PGRacing/BSPD-07/README.md

# BSPD-07

[Formula Student Rules 2023, Version 1.1, RULES ABOUT BSPD IN FSG](https://github.com/PGRacing/BSPD-07/blob/7362ee8c0faeef61a98c81634c0c87ed86c11af4/DOCS/Formula%20Student%20Rules%202023,%20Version%201.1,%20Rev-44c3679%20-%20FS-Rules_2023_v1.1(BSPD).pdf)
