PGRacing/BSPD-07/PCB/BSPD-07/BSPD-07.xlsx

Sheet: BSPD-07
Source:,"C:\Users\Karol\Documents\GitHub\BSPD-07\PCB\BSPD-07\BSPD-07.kicad_sch"
Date:,"17.04.2025 21:27:53"
Tool:,"Eeschema (6.0.8)"
Generator:,"C:\Program Files\KiCad\6.0\bin\scripting\plugins/bom_csv_grouped_by_value.py"
Component Count:,"82"
Individual Components:
Item,"Qty","Reference(s)","Value","LibPart","Footprint","Datasheet","Arrow Part Number","Arrow Price/Stock","Description","Height","Manufacturer_Name","Manufacturer_Part_Number","Mouser Part Number","Mouser Price/Stock"
,"","C1","0.1uF","Device:C_Small","Capacitor_SMD:C_0402_1005Metric","~","","","","","","","",""
,"","C2","0.1uF","Device:C_Small","Capacitor_SMD:C_0402_1005Metric","~","","","","","","","",""
,"","C3","10uF","Device:C_Small","Capacitor_SMD:C_0805_2012Metric","~","","","","","","","",""
,"","C4","0.1uF","Device:C_Small","Capacitor_SMD:C_0402_1005Metric","~","","","","","","","",""
,"","C5","10uF","Device:C_Small","Capacitor_SMD:C_1206_3216Metric","~","","","","","","","",""
,"","C6","1uF","Device:C_Small","Capacitor_SMD:C_0805_2012Metric","~","","","","","","","",""
,"","C7","4.7uF","Device:C_Small","Capacitor_SMD:C_0805_2012Metric","~","","","","","","","",""
,"","C8","0.1u","Device:C_Small","Capacitor_SMD:C_0402_1005Metric","~","","","","","","","",""
,"","C9","0.1uF","Device:C_Small","Capacitor_SMD:C_0402_1005Metric","~","","","","","","","",""
,"","C10","na","Device:C_Small","Capacitor_SMD:C_0402_1005Metric","~","","","","","","","",""
,"","C11","na","Device:C_Small","Capacitor_SMD:C_0402_1005Metric","~","","","","","","","",""
,"","C12","10uF","Device:C_Small","Capacitor_SMD:C_1206_3216Metric","~","","","","","","","",""
,"","C13","10uF","Device:C_Small","Capacitor_SMD:C_1206_3216Metric","~","","","","","","","",""
,"","C14","10uF","Device:C_Small","Capacitor_SMD:C_1206_3216Metric","~","","","","","","","",""
,"","C15","10uF","Device:C_Small","Capacitor_SMD:C_1206_3216Metric","~","","","","","","","",""
,"","C16","10uF","Device:C_Small","Capacitor_SMD:C_1206_3216Metric","~","","","","","","","",""
,"","C17","10uF","Device:C_Small","Capacitor_SMD:C_1206_3216Metric","~","","","","","","","",""
,"","C18","10uF","Device:C_Small","Capacitor_SMD:C_1206_3216Metric","~","","","","","","","",""
,"","C19","10uF","Device:C_Small","Capacitor_SMD:C_1206_3216Metric","~","","","","","","","",""
,"","C20","10uF","Device:C_Small","Capacitor_SMD:C_1206_3216Metric","~","","","","","","","",""
,"","C21","100pF/50V","Device:C_Small","Capacitor_SMD:C_0402_1005Metric","~","","","","","","","",""
,"","C22","100nF/50V","Device:C_Small","Capacitor_SMD:C_0402_1005Metric","~","","","","","","","",""
,"","D1","7V","Device:D_TVS","Diode_SMD:D_0402_1005Metric","~","","","","","","","",""
,"","D2","7V","Device:D_TVS","Diode_SMD:D_0402_1005Metric","~","","","","","","","",""
,"","D3","LED","Device:LED","Diode_SMD:D_0402_1005Metric_Pad0.77x0.64mm_HandSolder","~","","","","","","","",""
,"","D4","LED","Device:LED","Diode_SMD:D_0402_1005Metric_Pad0.77x0.64mm_HandSolder","~","","","","","","","",""
,"","D5","28V","Device:D_TVS","Diode_SMD:D_SMA","~","","","","","","","",""
,"","D6","1N4448WS","Diode:1N4448WS","Diode_SMD:D_SOD-323","https://www.vishay.com/docs/81387/1n4448ws.pdf","","","","","","","",""
,"","F1","500mA","Device:Fuse_Small","Fuse:Fuse_0805_2012Metric","~","","","","","","","",""
,"","FB1","110E","Device:FerriteBead_Small","LED_SMD:LED_0805_2012Metric","~","","","","","","","",""
,"","IC1","LM393LVQDRQ1","BSPD-07:LM393LVQDRQ1","BSPD_07:SOIC127P600X175-8N","https://www.ti.com/lit/gpn/lm393lv-q1","LM393LVQDRQ1","https://www.arrow.com/en/products/lm393lvqdrq1/texas-instruments?region=nac","Analog Comparators Automotive low-voltage commodity comparator 8-SOIC -40 to 125","1.75","Texas Instruments","LM393LVQDRQ1","595-LM393LVQDRQ1","https://www.mouser.co.uk/ProductDetail/Texas-Instruments/LM393LVQDRQ1?qs=IS%252B4QmGtzzqk8QFsvXuXMw%3D%3D"
,"","IC2","LM393LVQDRQ1","BSPD-07:LM393LVQDRQ1","BSPD_07:SOIC127P600X175-8N","https://www.ti.com/lit/gpn/lm393lv-q1","LM393LVQDRQ1","https://www.arrow.com/en/products/lm393lvqdrq1/texas-instruments?region=nac","Analog Comparators Automotive low-voltage commodity comparator 8-SOIC -40 to 125","1.75","Texas Instruments","LM393LVQDRQ1","595-LM393LVQDRQ1","https://www.mouser.co.uk/ProductDetail/Texas-Instruments/LM393LVQDRQ1?qs=IS%252B4QmGtzzqk8QFsvXuXMw%3D%3D"
,"","IC3","LM393LVQDRQ1",":LM393LVQDRQ1_1","BSPD_07:SOIC127P600X175-8N","https://www.ti.com/lit/gpn/lm393lv-q1","LM393LVQDRQ1","https://www.arrow.com/en/products/lm393lvqdrq1/texas-instruments?region=nac","Analog Comparators Automotive low-voltage commodity comparator 8-SOIC -40 to 125","1.75","Texas Instruments","LM393LVQDRQ1","595-LM393LVQDRQ1","https://www.mouser.co.uk/ProductDetail/Texas-Instruments/LM393LVQDRQ1?qs=IS%252B4QmGtzzqk8QFsvXuXMw%3D%3D"
,"","IC4","LDO40LPU50RY","BSPD-07:LDO40LPU50RY","BSPD_07:SON95P300X300X90-7N-D","https://componentsearchengine.com/Datasheets/1/LDO40LPU50RY.pdf","LDO40LPU50RY","https://www.arrow.com/en/products/ldo40lpu50ry/stmicroelectronics?region=nac","LDO Voltage Regulators 400 mA, 38 V low-dropout regulator","0.9","STMicroelectronics","LDO40LPU50RY","511-LDO40LPU50RY","https://www.mouser.co.uk/ProductDetail/STMicroelectronics/LDO40LPU50RY?qs=qSfuJ%252Bfl%2Fd76TFu8P3XttQ%3D%3D"
,"","IC5","74LVC1G02GW-Q100H","BSPD-07:74LVC1G02GW-Q100H","BSPD_07:SOT65P212X110-5N","https://assets.nexperia.com/documents/data-sheet/74LVC1G02_Q100.pdf","74LVC1G02GW-Q100H","https://www.arrow.com/en/products/74lvc1g02gw-q100h/nexperia","Single 2-input NOR gate@en-us","1.1","Nexperia","74LVC1G02GW-Q100H","771-74LVC1G02GWQ100H","https://www.mouser.co.uk/ProductDetail/Nexperia/74LVC1G02GW-Q100H?qs=5XOdhvmYM0OXtjyYuTuWfw%3D%3D"
,"","IC6","LM393LVQDRQ1","BSPD-07:LM393LVQDRQ1","BSPD_07:SOIC127P600X175-8N","https://www.ti.com/lit/gpn/lm393lv-q1","LM393LVQDRQ1","https://www.arrow.com/en/products/lm393lvqdrq1/texas-instruments?region=nac","Analog Comparators Automotive low-voltage commodity comparator 8-SOIC -40 to 125","1.75","Texas Instruments","LM393LVQDRQ1","595-LM393LVQDRQ1","https://www.mouser.co.uk/ProductDetail/Texas-Instruments/LM393LVQDRQ1?qs=IS%252B4QmGtzzqk8QFsvXuXMw%3D%3D"
,"","J1","DTM13-12PA","BSPD-07:DTM13-12PA","BSPD_07:DTM1312PA","https://datasheet.datasheetarchive.com/originals/distributors/DKDS-22/431684.pdf","","","Automotive Connectors 12P SZ 20 DTM RECP","35.18","TE Connectivity","DTM13-12PA","571-DTM13-12PA","https://www.mouser.co.uk/ProductDetail/TE-Connectivity-DEUTSCH/DTM13-12PA?qs=cgQJD%2FpJz0wRVbmAAJ6nZw%3D%3D"
,"","JP1","Jumper_2_Open","Jumper:Jumper_2_Open","Connector_PinHeader_2.54mm:PinHeader_1x02_P2.54mm_Vertical","~","","","","","","","",""
,"","L1","120uH / 0.5A","Device:L_Small","Inductor_SMD:L_1812_4532Metric","~","","","","","","","",""
,"","Q1","RSQ025P03HZGTR","BSPD-07:RSQ025P03HZGTR","BSPD_07:SOT95P280X100-6N","https://fscdn.rohm.com/en/products/databook/datasheet/discrete/transistor/mosfet/rsq025p03hzgtr-e.pdf","","","Pch -30V -2.5A Small Signal MOSFET","1","ROHM Semiconductor","RSQ025P03HZGTR","755-RSQ025P03HZGTR","https://www.mouser.co.uk/ProductDetail/ROHM-Semiconductor/RSQ025P03HZGTR?qs=0lSvoLzn4L%2F9YbrdTwpoKg%3D%3D"
,"","Q2","RJU002N06FRAT106","BSPD-07:RJU002N06FRAT106","BSPD_07:SOT65P210X100-3N","https://datasheet.datasheetarchive.com/originals/distributors/DKDS-10/185695.pdf","","","ROHM - RJU002N06FRAT106 - MOSFET, AEC-Q101, N-CH, 60V, 0.2A, UMT3","1","ROHM Semiconductor","RJU002N06FRAT106","755-RJU002N06FRAT106","https://www.mouser.com/Search/Refine.aspx?Keyword=755-RJU002N06FRAT106"
,"","Q3","RJU002N06FRAT106","BSPD-07:RJU002N06FRAT106","BSPD_07:SOT65P210X100-3N","https://datasheet.datasheetarchive.com/originals/distributors/DKDS-10/185695.pdf","","","ROHM - RJU002N06FRAT106 - MOSFET, AEC-Q101, N-CH, 60V, 0.2A, UMT3","1","ROHM Semiconductor","RJU002N06FRAT106","755-RJU002N06FRAT106","https://www.mouser.com/Search/Refine.aspx?Keyword=755-RJU002N06FRAT106"
,"","Q4","AO3401A","Transistor_FET:AO3401A","Package_TO_SOT_SMD:SOT-23","http://www.aosmd.com/pdfs/datasheet/AO3401A.pdf","","","","","","","",""
,"","R1","100k","Device:R_Small","Resistor_SMD:R_0402_1005Metric","~","","","","","","","",""
,"","R2","100k","Device:R_Small","Resistor_SMD:R_0402_1005Metric","~","","","","","","","",""
,"","R3","5k-10k","Device:R_Small","Resistor_SMD:R_0402_1005Metric","~","","","","","","","",""
,"","R4","10k","Device:R_Small","Resistor_SMD:R_0402_1005Metric","~","","","","","","","",""
,"","R5","5k-10k","Device:R_Small","Resistor_SMD:R_0402_1005Metric","~","","","","","","","",""
,"","R6","10k","Device:R_Small","Resistor_SMD:R_0402_1005Metric","~","","","","","","","",""
,"","R7","200k","Device:R_Small","Resistor_SMD:R_0402_1005Metric","~","","","","","","","",""
,"","R8","200k","Device:R_Small","Resistor_SMD:R_0402_1005Metric","~","","","","","","","",""
,"","R9","10k","Device:R_Small","Resistor_SMD:R_0402_1005Metric","~","","","","","","","",""
,"","R10","10k","Device:R_Small","Resistor_SMD:R_0402_1005Metric","~","","","","","","","",""
,"","R11","100k","Device:R_Small","Resistor_SMD:R_0402_1005Metric","~","","","","","","","",""
,"","R12","39k","Device:R_Small","Resistor_SMD:R_0402_1005Metric","~","","","","","","","",""
,"","R13","39k","Device:R_Small","Resistor_SMD:R_0402_1005Metric","~","","","","","","","",""
,"","R14","5R2","Device:R_Small","Resistor_SMD:R_0402_1005Metric","~","","","","","","","",""
,"","R15","560k","Device:R_Small","Resistor_SMD:R_0402_1005Metric","~","","","","","","","",""
,"","R16","100","Device:R_Small","Resistor_SMD:R_0402_1005Metric","~","","","","","","","",""
,"","R17","10k","Device:R_Small","Resistor_SMD:R_0402_1005Metric","~","","","","","","","",""
,"","R18","10k","Device:R_Small","Resistor_SMD:R_0402_1005Metric","~","","","","","","","",""
,"","R19","10k","Device:R_Small","Resistor_SMD:R_0402_1005Metric","~","","","","","","","",""
,"","R20","560k","Device:R_Small","Resistor_SMD:R_0402_1005Metric","~","","","","","","","",""
,"","R21","3R9","Device:R_Small","Resistor_SMD:R_0402_1005Metric","~","","","","","","","",""
,"","R22","1k","Device:R_Small","Resistor_SMD:R_0402_1005Metric","~","","","","","","","",""
,"","R23","152","Device:R_Small","Resistor_SMD:R_0402_1005Metric","~","","","","","","","",""
,"","R24","145","Device:R_Small","Resistor_SMD:R_0402_1005Metric","~","","","","","","","",""
,"","R25","39k","Device:R_Small","Resistor_SMD:R_0402_1005Metric","~","","","","","","","",""
,"","R26","10k","Device:R_Small","Resistor_SMD:R_0402_1005Metric","~","","","","","","","",""
,"","R27","200R","Device:R_Small","Resistor_SMD:R_0402_1005Metric","~","","","","","","","",""
,"","R28","100","Device:R_Small","Resistor_SMD:R_0402_1005Metric","~","","","","","","","",""
,"","R29","200","Device:R_Small","Resistor_SMD:R_0402_1005Metric","~","","","","","","","",""
,"","R30","10k","Device:R_Small","Resistor_SMD:R_0402_1005Metric","~","","","","","","","",""
,"","R31","na","Device:R_Small","Resistor_SMD:R_0402_1005Metric","~","","","","","","","",""
,"","R32","na","Device:R_Small","Resistor_SMD:R_0402_1005Metric","~","","","","","","","",""
,"","RV1","20k","Device:R_Potentiometer_Small","BSPD_07:POT-3296X1223LF","~","","","","","","","",""
,"","RV2","20k","Device:R_Potentiometer_Small","BSPD_07:POT-3296X1223LF","~","","","","","","","",""
,"","TP1","TPS","Connector:TestPoint_Small","TestPoint:TestPoint_Pad_D1.0mm","~","","","","","","","",""
,"","TP2","BRK","Connector:TestPoint_Small","TestPoint:TestPoint_Pad_D1.0mm","~","","","","","","","",""
,"","TP3","ERR_FINAL","Connector:TestPoint_Small","TestPoint:TestPoint_Pad_D1.0mm","~","","","","","","","",""
,"","TP4","CUR","Connector:TestPoint_Small","TestPoint:TestPoint_Pad_D1.0mm","~","","","","","","","",""
,"","U2","TLP175A / COMUS AB38-Q","Relay_SolidState:TLP175A","Package_SO:MFSOP6-4_4.4x3.6mm_P1.27mm","https://toshiba.semicon-storage.com/info/docget.jsp?did=13665&prodName=TLP175A","","","","","","","",""
Collated Components:
Item,"Qty","Reference(s)","Value","LibPart","Footprint","Datasheet","Arrow Part Number","Arrow Price/Stock","Description","Height","Manufacturer_Name","Manufacturer_Part_Number","Mouser Part Number","Mouser Price/Stock"
1,"4","C1, C2, C4, C9","0.1uF","Device:C_Small","Capacitor_SMD:C_0402_1005Metric","~","","","","","","","",""
2,"1","C3","10uF","Device:C_Small","Capacitor_SMD:C_0805_2012Metric","~","","","","","","","",""
3,"10","C5, C12, C13, C14, C15, C16, C17, C18, C19, C20","10uF","Device:C_Small","Capacitor_SMD:C_1206_3216Metric","~","","","","","","","",""
4,"1","C6","1uF","Device:C_Small","Capacitor_SMD:C_0805_2012Metric","~","","","","","","","",""
5,"1","C7","4.7uF","Device:C_Small","Capacitor_SMD:C_0805_2012Metric","~","","","","","","","",""
6,"1","C8","0.1u","Device:C_Small","Capacitor_SMD:C_0402_1005Metric","~","","","","","","","",""
7,"2","C10, C11","na","Device:C_Small","Capacitor_SMD:C_0402_1005Metric","~","","","","","","","",""
8,"1","C21","100pF/50V","Device:C_Small","Capacitor_SMD:C_0402_1005Metric","~","","","","","","","",""
9,"1","C22","100nF/50V","Device:C_Small","Capacitor_SMD:C_0402_1005Metric","~","","","","","","","",""
10,"2","D1, D2","7V","Device:D_TVS","Diode_SMD:D_0402_1005Metric","~","","","","","","","",""
11,"2","D3, D4","LED","Device:LED","Diode_SMD:D_0402_1005Metric_Pad0.77x0.64mm_HandSolder","~","","","","","","","",""
12,"1","D5","28V","Device:D_TVS","Diode_SMD:D_SMA","~","","","","","","","",""
13,"1","D6","1N4448WS","Diode:1N4448WS","Diode_SMD:D_SOD-323","https://www.vishay.com/docs/81387/1n4448ws.pdf","","","","","","","",""
14,"1","F1","500mA","Device:Fuse_Small","Fuse:Fuse_0805_2012Metric","~","","","","","","","",""
15,"1","FB1","110E","Device:FerriteBead_Small","LED_SMD:LED_0805_2012Metric","~","","","","","","","",""
16,"3","IC1, IC2, IC6","LM393LVQDRQ1","BSPD-07:LM393LVQDRQ1","BSPD_07:SOIC127P600X175-8N","https://www.ti.com/lit/gpn/lm393lv-q1","LM393LVQDRQ1","https://www.arrow.com/en/products/lm393lvqdrq1/texas-instruments?region=nac","Analog Comparators Automotive low-voltage commodity comparator 8-SOIC -40 to 125","1.75","Texas Instruments","LM393LVQDRQ1","595-LM393LVQDRQ1","https://www.mouser.co.uk/ProductDetail/Texas-Instruments/LM393LVQDRQ1?qs=IS%252B4QmGtzzqk8QFsvXuXMw%3D%3D"
17,"1","IC3","LM393LVQDRQ1",":LM393LVQDRQ1_1","BSPD_07:SOIC127P600X175-8N","https://www.ti.com/lit/gpn/lm393lv-q1","LM393LVQDRQ1","https://www.arrow.com/en/products/lm393lvqdrq1/texas-instruments?region=nac","Analog Comparators Automotive low-voltage commodity comparator 8-SOIC -40 to 125","1.75","Texas Instruments","LM393LVQDRQ1","595-LM393LVQDRQ1","https://www.mouser.co.uk/ProductDetail/Texas-Instruments/LM393LVQDRQ1?qs=IS%252B4QmGtzzqk8QFsvXuXMw%3D%3D"
18,"1","IC4","LDO40LPU50RY","BSPD-07:LDO40LPU50RY","BSPD_07:SON95P300X300X90-7N-D","https://componentsearchengine.com/Datasheets/1/LDO40LPU50RY.pdf","LDO40LPU50RY","https://www.arrow.com/en/products/ldo40lpu50ry/stmicroelectronics?region=nac","LDO Voltage Regulators 400 mA, 38 V low-dropout regulator","0.9","STMicroelectronics","LDO40LPU50RY","511-LDO40LPU50RY","https://www.mouser.co.uk/ProductDetail/STMicroelectronics/LDO40LPU50RY?qs=qSfuJ%252Bfl%2Fd76TFu8P3XttQ%3D%3D"
19,"1","IC5","74LVC1G02GW-Q100H","BSPD-07:74LVC1G02GW-Q100H","BSPD_07:SOT65P212X110-5N","https://assets.nexperia.com/documents/data-sheet/74LVC1G02_Q100.pdf","74LVC1G02GW-Q100H","https://www.arrow.com/en/products/74lvc1g02gw-q100h/nexperia","Single 2-input NOR gate@en-us","1.1","Nexperia","74LVC1G02GW-Q100H","771-74LVC1G02GWQ100H","https://www.mouser.co.uk/ProductDetail/Nexperia/74LVC1G02GW-Q100H?qs=5XOdhvmYM0OXtjyYuTuWfw%3D%3D"
20,"1","J1","DTM13-12PA","BSPD-07:DTM13-12PA","BSPD_07:DTM1312PA","https://datasheet.datasheetarchive.com/originals/distributors/DKDS-22/431684.pdf","","","Automotive Connectors 12P SZ 20 DTM RECP","35.18","TE Connectivity","DTM13-12PA","571-DTM13-12PA","https://www.mouser.co.uk/ProductDetail/TE-Connectivity-DEUTSCH/DTM13-12PA?qs=cgQJD%2FpJz0wRVbmAAJ6nZw%3D%3D"
21,"1","JP1","Jumper_2_Open","Jumper:Jumper_2_Open","Connector_PinHeader_2.54mm:PinHeader_1x02_P2.54mm_Vertical","~","","","","","","","",""
22,"1","L1","120uH / 0.5A","Device:L_Small","Inductor_SMD:L_1812_4532Metric","~","","","","","","","",""
23,"1","Q1","RSQ025P03HZGTR","BSPD-07:RSQ025P03HZGTR","BSPD_07:SOT95P280X100-6N","https://fscdn.rohm.com/en/products/databook/datasheet/discrete/transistor/mosfet/rsq025p03hzgtr-e.pdf","","","Pch -30V -2.5A Small Signal MOSFET","1","ROHM Semiconductor","RSQ025P03HZGTR","755-RSQ025P03HZGTR","https://www.mouser.co.uk/ProductDetail/ROHM-Semiconductor/RSQ025P03HZGTR?qs=0lSvoLzn4L%2F9YbrdTwpoKg%3D%3D"
24,"2","Q2, Q3","RJU002N06FRAT106","BSPD-07:RJU002N06FRAT106","BSPD_07:SOT65P210X100-3N","https://datasheet.datasheetarchive.com/originals/distributors/DKDS-10/185695.pdf","","","ROHM - RJU002N06FRAT106 - MOSFET, AEC-Q101, N-CH, 60V, 0.2A, UMT3","1","ROHM Semiconductor","RJU002N06FRAT106","755-RJU002N06FRAT106","https://www.mouser.com/Search/Refine.aspx?Keyword=755-RJU002N06FRAT106"
25,"1","Q4","AO3401A","Transistor_FET:AO3401A","Package_TO_SOT_SMD:SOT-23","http://www.aosmd.com/pdfs/datasheet/AO3401A.pdf","","","","","","","",""
26,"3","R1, R2, R11","100k","Device:R_Small","Resistor_SMD:R_0402_1005Metric","~","","","","","","","",""
27,"2","R3, R5","5k-10k","Device:R_Small","Resistor_SMD:R_0402_1005Metric","~","","","","","","","",""
28,"9","R4, R6, R9, R10, R17, R18, R19, R26, R30","10k","Device:R_Small","Resistor_SMD:R_0402_1005Metric","~","","","","","","","",""
29,"2","R7, R8","200k","Device:R_Small","Resistor_SMD:R_0402_1005Metric","~","","","","","","","",""
30,"3","R12, R13, R25","39k","Device:R_Small","Resistor_SMD:R_0402_1005Metric","~","","","","","","","",""
31,"1","R14","5R2","Device:R_Small","Resistor_SMD:R_0402_1005Metric","~","","","","","","","",""
32,"2","R15, R20","560k","Device:R_Small","Resistor_SMD:R_0402_1005Metric","~","","","","","","","",""
33,"2","R16, R28","100","Device:R_Small","Resistor_SMD:R_0402_1005Metric","~","","","","","","","",""
34,"1","R21","3R9","Device:R_Small","Resistor_SMD:R_0402_1005Metric","~","","","","","","","",""
35,"1","R22","1k","Device:R_Small","Resistor_SMD:R_0402_1005Metric","~","","","","","","","",""
36,"1","R23","152","Device:R_Small","Resistor_SMD:R_0402_1005Metric","~","","","","","","","",""
37,"1","R24","145","Device:R_Small","Resistor_SMD:R_0402_1005Metric","~","","","","","","","",""
38,"1","R27","200R","Device:R_Small","Resistor_SMD:R_0402_1005Metric","~","","","","","","","",""
39,"1","R29","200","Device:R_Small","Resistor_SMD:R_0402_1005Metric","~","","","","","","","",""
40,"2","R31, R32","na","Device:R_Small","Resistor_SMD:R_0402_1005Metric","~","","","","","","","",""
41,"2","RV1, RV2","20k","Device:R_Potentiometer_Small","BSPD_07:POT-3296X1223LF","~","","","","","","","",""
42,"1","TP1","TPS","Connector:TestPoint_Small","TestPoint:TestPoint_Pad_D1.0mm","~","","","","","","","",""
43,"1","TP2","BRK","Connector:TestPoint_Small","TestPoint:TestPoint_Pad_D1.0mm","~","","","","","","","",""
44,"1","TP3","ERR_FINAL","Connector:TestPoint_Small","TestPoint:TestPoint_Pad_D1.0mm","~","","","","","","","",""
45,"1","TP4","CUR","Connector:TestPoint_Small","TestPoint:TestPoint_Pad_D1.0mm","~","","","","","","","",""
46,"1","U2","TLP175A / COMUS AB38-Q","Relay_SolidState:TLP175A","Package_SO:MFSOP6-4_4.4x3.6mm_P1.27mm","https://toshiba.semicon-storage.com/info/docget.jsp?did=13665&prodName=TLP175A","","","","","","","",""

Sheet: Tabela1
Item | Qty | Reference | Value | Kolumna6 | Kolumna7 | Kolumna8 | Kolumna9 | Kolumna10 | Kolumna11 | Kolumna12 | Kolumna13 | Kolumna14 | Kolumna15
1 | 5 | C1, C2, C4, C8, C9 | 0.1uF | Capacitor_SMD:C_0402_1005Metric | ~
2 | 1 | C3 | 10uF | Capacitor_SMD:C_0805_2012Metric | ~
 | 4 | C17, C18, C19, C20 | 22uF | 1206
 | 6 | C5, C12, C13, C14, C15, C16 | 4.7uF | Capacitor_SMD:C_1206_3216Metric | ~
4 | 1 | C6 | 1uF | Capacitor_SMD:C_0805_2012Metric | ~
5 | 1 | C7 | 4.7uF | Capacitor_SMD:C_0805_2012Metric | ~
7 | 2 | C10, C11 | 1uF | Capacitor_SMD:C_0402_1005Metric | ~
8 | 1 | C21 | 100pF/50V | Capacitor_SMD:C_0402_1005Metric | ~
9 | 1 | C22 | 100nF/50V | Capacitor_SMD:C_0402_1005Metric | ~
10 | 2 | D1, D2 | 7V | Diode_SMD:D_0402_1005Metric | ~
11 | 2 | D3, D4 | LED | Diode_SMD:D_0402_1005Metric_Pad0.77x0.64mm_HandSolder | ~
12 | 1 | D5 | SMAJ28CA | Diode_SMD:D_SMA | ~
13 | 1 | D6 | 1N4448WS | Diode_SMD:D_SOD-323 | https://www.vishay.com/docs/81387/1n4448ws.pdf
14 | 1 | F1 | 500mA | Fuse:Fuse_0805_2012Metric | ~
15 | 1 | FB1 | 110E | LED_SMD:LED_0805_2012Metric | ~
16 | 4 | IC1, IC2,IC3, IC6 | LM393LVQDRQ1 | BSPD_07:SOIC127P600X175-8N | https://www.ti.com/lit/gpn/lm393lv-q1 | LM393LVQDRQ1 | https://www.arrow.com/en/products/lm393lvqdrq1/texas-instruments?region=nac | Analog Comparators Automotive low-voltage commodity comparator 8-SOIC -40 to 125 | 1.75 | Texas Instruments | LM393LVQDRQ1 | 595-LM393LVQDRQ1 | https://www.mouser.co.uk/ProductDetail/Texas-Instruments/LM393LVQDRQ1?qs=IS%252B4QmGtzzqk8QFsvXuXMw%3D%3D
18 | 1 | IC4 | LDO40LPU50RY | BSPD_07:SON95P300X300X90-7N-D | https://componentsearchengine.com/Datasheets/1/LDO40LPU50RY.pdf | LDO40LPU50RY | https://www.arrow.com/en/products/ldo40lpu50ry/stmicroelectronics?region=nac | LDO Voltage Regulators 400 mA, 38 V low-dropout regulator | 0.9 | STMicroelectronics | LDO40LPU50RY | 511-LDO40LPU50RY | https://www.mouser.co.uk/ProductDetail/STMicroelectronics/LDO40LPU50RY?qs=qSfuJ%252Bfl%2Fd76TFu8P3XttQ%3D%3D
19 | 1 | IC5 | 74LVC1G02GW-Q100H | BSPD_07:SOT65P212X110-5N | https://assets.nexperia.com/documents/data-sheet/74LVC1G02_Q100.pdf | 74LVC1G02GW-Q100H | https://www.arrow.com/en/products/74lvc1g02gw-q100h/nexperia | Single 2-input NOR gate@en-us | 1.1 | Nexperia | 74LVC1G02GW-Q100H | 771-74LVC1G02GWQ100H | https://www.mouser.co.uk/ProductDetail/Nexperia/74LVC1G02GW-Q100H?qs=5XOdhvmYM0OXtjyYuTuWfw%3D%3D
20 | 1 | J1 | DTM13-12PA | BSPD_07:DTM1312PA | https://datasheet.datasheetarchive.com/originals/distributors/DKDS-22/431684.pdf |  |  | Automotive Connectors 12P SZ 20 DTM RECP | 35.18 | TE Connectivity | DTM13-12PA | 571-DTM13-12PA | https://www.mouser.co.uk/ProductDetail/TE-Connectivity-DEUTSCH/DTM13-12PA?qs=cgQJD%2FpJz0wRVbmAAJ6nZw%3D%3D
~~21~~ | ~~1~~ | ~~JP1~~ | ~~Jumper_2_Open~~ | ~~Connector_PinHeader_2.54mm:PinHeader_1x02_P2.54mm_Vertical~~ | ~~~~~
22 | 1 | L1 | 120uH / 0.5A | Inductor_SMD:L_1812_4532Metric | ~
23 | 1 | Q1 | RSQ025P03HZGTR | BSPD_07:SOT95P280X100-6N | https://fscdn.rohm.com/en/products/databook/datasheet/discrete/transistor/mosfet/rsq025p03hzgtr-e.pdf |  |  | Pch -30V -2.5A Small Signal MOSFET | 1 | ROHM Semiconductor | RSQ025P03HZGTR | 755-RSQ025P03HZGTR | https://www.mouser.co.uk/ProductDetail/ROHM-Semiconductor/RSQ025P03HZGTR?qs=0lSvoLzn4L%2F9YbrdTwpoKg%3D%3D
24 | 2 | Q2, Q3 | RJU002N06FRAT106 | BSPD_07:SOT65P210X100-3N | https://datasheet.datasheetarchive.com/originals/distributors/DKDS-10/185695.pdf |  |  | ROHM - RJU002N06FRAT106 - MOSFET, AEC-Q101, N-CH, 60V, 0.2A, UMT3 | 1 | ROHM Semiconductor | RJU002N06FRAT106 | 755-RJU002N06FRAT106 | https://www.mouser.com/Search/Refine.aspx?Keyword=755-RJU002N06FRAT106
25 | 1 | Q4 | SI2319CDS | Package_TO_SOT_SMD:SOT-23 | http://www.aosmd.com/pdfs/datasheet/AO3401A.pdf
26 | 3 | R1, R2, R11 | 100k | Resistor_SMD:R_0402_1005Metric | ~
27 | 2 | R3, R5 | 6k2 | Resistor_SMD:R_0402_1005Metric | ~
28 | 9 | R4, R6, R9, R10, R17, R18, R19, R26, R30 | 10k | Resistor_SMD:R_0402_1005Metric | ~
29 | 2 | R7, R8 | 200k | Resistor_SMD:R_0402_1005Metric | ~
30 | 3 | R12, R13, R25 | 39k | Resistor_SMD:R_0402_1005Metric | ~
31 | 1 | R14 | 5R2 | Resistor_SMD:R_0402_1005Metric | ~
32 | 2 | R15, R20 | 560k | Resistor_SMD:R_0402_1005Metric | ~
33 | 2 | R16, R28 | 100 | Resistor_SMD:R_0402_1005Metric | ~
34 | 1 | R21 | 3R9 | Resistor_SMD:R_0402_1005Metric | ~
35 | 1 | R22 | 390 | Resistor_SMD:R_0402_1005Metric | Changed to 390
36 | 1 | R23 | 390 | Resistor_SMD:R_0402_1005Metric | Changed to 391
37 | 1 | R24 | 390 | Resistor_SMD:R_0402_1005Metric | Changed to 392
38 | 2 | R27,R29 | 200R | Resistor_SMD:R_0402_1005Metric | ~
40 | 2 | R31, R32 | 1k2 | Resistor_SMD:R_0402_1005Metric | ~
41 | 2 | RV1, RV2 | 20k | BSPD_07:POT-3296X1223LF | ~
42 | 1 | TP1 | TPS | TestPoint:TestPoint_Pad_D1.0mm | ~
43 | 1 | TP2 | BRK | TestPoint:TestPoint_Pad_D1.0mm | ~
44 | 1 | TP3 | ERR_FINAL | TestPoint:TestPoint_Pad_D1.0mm | ~
45 | 1 | TP4 | CUR | TestPoint:TestPoint_Pad_D1.0mm | ~
46 | 1 | U2 | TLP175A / COMUS AB38-Q | Package_SO:MFSOP6-4_4.4x3.6mm_P1.27mm | https://toshiba.semicon-storage.com/info/docget.jsp?did=13665&prodName=TLP175A

Sheet: Arkusz1
Item,"Qty","Reference(s)","Value","LibPart","Footprint","Datasheet","Arrow Part Number","Arrow Price/Stock","Description","Height","Manufacturer_Name","Manufacturer_Part_Number","Mouser Part Number","Mouser Price/Stock"
1,"4","C1, C2, C4, C9","0.1uF","Device:C_Small","Capacitor_SMD:C_0402_1005Metric","~","","","","","","","",""
2,"1","C3","10uF","Device:C_Small","Capacitor_SMD:C_0805_2012Metric","~","","","","","","","",""
3,"10","C5, C12, C13, C14, C15, C16, C17, C18, C19, C20","10uF","Device:C_Small","Capacitor_SMD:C_1206_3216Metric","~","","","","","","","",""
4,"1","C6","1uF","Device:C_Small","Capacitor_SMD:C_0805_2012Metric","~","","","","","","","",""
5,"1","C7","4.7uF","Device:C_Small","Capacitor_SMD:C_0805_2012Metric","~","","","","","","","",""
6,"1","C8","0.1u","Device:C_Small","Capacitor_SMD:C_0402_1005Metric","~","","","","","","","",""
7,"2","C10, C11","na","Device:C_Small","Capacitor_SMD:C_0402_1005Metric","~","","","","","","","",""
8,"1","C21","100pF/50V","Device:C_Small","Capacitor_SMD:C_0402_1005Metric","~","","","","","","","",""
9,"1","C22","100nF/50V","Device:C_Small","Capacitor_SMD:C_0402_1005Metric","~","","","","","","","",""
10,"2","D1, D2","7V","Device:D_TVS","Diode_SMD:D_0402_1005Metric","~","","","","","","","",""
11,"2","D3, D4","LED","Device:LED","Diode_SMD:D_0402_1005Metric_Pad0.77x0.64mm_HandSolder","~","","","","","","","",""
12,"1","D5","28V","Device:D_TVS","Diode_SMD:D_SMA","~","","","","","","","",""
13,"1","D6","1N4448WS","Diode:1N4448WS","Diode_SMD:D_SOD-323","https://www.vishay.com/docs/81387/1n4448ws.pdf","","","","","","","",""
14,"1","F1","500mA","Device:Fuse_Small","Fuse:Fuse_0805_2012Metric","~","","","","","","","",""
15,"1","FB1","110E","Device:FerriteBead_Small","LED_SMD:LED_0805_2012Metric","~","","","","","","","",""
16,"3","IC1, IC2, IC6","LM393LVQDRQ1","BSPD-07:LM393LVQDRQ1","BSPD_07:SOIC127P600X175-8N","https://www.ti.com/lit/gpn/lm393lv-q1","LM393LVQDRQ1","https://www.arrow.com/en/products/lm393lvqdrq1/texas-instruments?region=nac","Analog Comparators Automotive low-voltage commodity comparator 8-SOIC -40 to 125","1.75","Texas Instruments","LM393LVQDRQ1","595-LM393LVQDRQ1","https://www.mouser.co.uk/ProductDetail/Texas-Instruments/LM393LVQDRQ1?qs=IS%252B4QmGtzzqk8QFsvXuXMw%3D%3D"
17,"1","IC3","LM393LVQDRQ1",":LM393LVQDRQ1_1","BSPD_07:SOIC127P600X175-8N","https://www.ti.com/lit/gpn/lm393lv-q1","LM393LVQDRQ1","https://www.arrow.com/en/products/lm393lvqdrq1/texas-instruments?region=nac","Analog Comparators Automotive low-voltage commodity comparator 8-SOIC -40 to 125","1.75","Texas Instruments","LM393LVQDRQ1","595-LM393LVQDRQ1","https://www.mouser.co.uk/ProductDetail/Texas-Instruments/LM393LVQDRQ1?qs=IS%252B4QmGtzzqk8QFsvXuXMw%3D%3D"
18,"1","IC4","LDO40LPU50RY","BSPD-07:LDO40LPU50RY","BSPD_07:SON95P300X300X90-7N-D","https://componentsearchengine.com/Datasheets/1/LDO40LPU50RY.pdf","LDO40LPU50RY","https://www.arrow.com/en/products/ldo40lpu50ry/stmicroelectronics?region=nac","LDO Voltage Regulators 400 mA, 38 V low-dropout regulator","0.9","STMicroelectronics","LDO40LPU50RY","511-LDO40LPU50RY","https://www.mouser.co.uk/ProductDetail/STMicroelectronics/LDO40LPU50RY?qs=qSfuJ%252Bfl%2Fd76TFu8P3XttQ%3D%3D"
19,"1","IC5","74LVC1G02GW-Q100H","BSPD-07:74LVC1G02GW-Q100H","BSPD_07:SOT65P212X110-5N","https://assets.nexperia.com/documents/data-sheet/74LVC1G02_Q100.pdf","74LVC1G02GW-Q100H","https://www.arrow.com/en/products/74lvc1g02gw-q100h/nexperia","Single 2-input NOR gate@en-us","1.1","Nexperia","74LVC1G02GW-Q100H","771-74LVC1G02GWQ100H","https://www.mouser.co.uk/ProductDetail/Nexperia/74LVC1G02GW-Q100H?qs=5XOdhvmYM0OXtjyYuTuWfw%3D%3D"
20,"1","J1","DTM13-12PA","BSPD-07:DTM13-12PA","BSPD_07:DTM1312PA","https://datasheet.datasheetarchive.com/originals/distributors/DKDS-22/431684.pdf","","","Automotive Connectors 12P SZ 20 DTM RECP","35.18","TE Connectivity","DTM13-12PA","571-DTM13-12PA","https://www.mouser.co.uk/ProductDetail/TE-Connectivity-DEUTSCH/DTM13-12PA?qs=cgQJD%2FpJz0wRVbmAAJ6nZw%3D%3D"
21,"1","JP1","Jumper_2_Open","Jumper:Jumper_2_Open","Connector_PinHeader_2.54mm:PinHeader_1x02_P2.54mm_Vertical","~","","","","","","","",""
22,"1","L1","120uH / 0.5A","Device:L_Small","Inductor_SMD:L_1812_4532Metric","~","","","","","","","",""
23,"1","Q1","RSQ025P03HZGTR","BSPD-07:RSQ025P03HZGTR","BSPD_07:SOT95P280X100-6N","https://fscdn.rohm.com/en/products/databook/datasheet/discrete/transistor/mosfet/rsq025p03hzgtr-e.pdf","","","Pch -30V -2.5A Small Signal MOSFET","1","ROHM Semiconductor","RSQ025P03HZGTR","755-RSQ025P03HZGTR","https://www.mouser.co.uk/ProductDetail/ROHM-Semiconductor/RSQ025P03HZGTR?qs=0lSvoLzn4L%2F9YbrdTwpoKg%3D%3D"
24,"2","Q2, Q3","RJU002N06FRAT106","BSPD-07:RJU002N06FRAT106","BSPD_07:SOT65P210X100-3N","https://datasheet.datasheetarchive.com/originals/distributors/DKDS-10/185695.pdf","","","ROHM - RJU002N06FRAT106 - MOSFET, AEC-Q101, N-CH, 60V, 0.2A, UMT3","1","ROHM Semiconductor","RJU002N06FRAT106","755-RJU002N06FRAT106","https://www.mouser.com/Search/Refine.aspx?Keyword=755-RJU002N06FRAT106"
25,"1","Q4","AO3401A","Transistor_FET:AO3401A","Package_TO_SOT_SMD:SOT-23","http://www.aosmd.com/pdfs/datasheet/AO3401A.pdf","","","","","","","",""
26,"3","R1, R2, R11","100k","Device:R_Small","Resistor_SMD:R_0402_1005Metric","~","","","","","","","",""
27,"2","R3, R5","5k-10k","Device:R_Small","Resistor_SMD:R_0402_1005Metric","~","","","","","","","",""
28,"9","R4, R6, R9, R10, R17, R18, R19, R26, R30","10k","Device:R_Small","Resistor_SMD:R_0402_1005Metric","~","","","","","","","",""
29,"2","R7, R8","200k","Device:R_Small","Resistor_SMD:R_0402_1005Metric","~","","","","","","","",""
30,"3","R12, R13, R25","39k","Device:R_Small","Resistor_SMD:R_0402_1005Metric","~","","","","","","","",""
31,"1","R14","5R2","Device:R_Small","Resistor_SMD:R_0402_1005Metric","~","","","","","","","",""
32,"2","R15, R20","560k","Device:R_Small","Resistor_SMD:R_0402_1005Metric","~","","","","","","","",""
33,"2","R16, R28","100","Device:R_Small","Resistor_SMD:R_0402_1005Metric","~","","","","","","","",""
34,"1","R21","3R9","Device:R_Small","Resistor_SMD:R_0402_1005Metric","~","","","","","","","",""
35,"1","R22","1k","Device:R_Small","Resistor_SMD:R_0402_1005Metric","~","","","","","","","",""
36,"1","R23","152","Device:R_Small","Resistor_SMD:R_0402_1005Metric","~","","","","","","","",""
37,"1","R24","145","Device:R_Small","Resistor_SMD:R_0402_1005Metric","~","","","","","","","",""
38,"1","R27","200R","Device:R_Small","Resistor_SMD:R_0402_1005Metric","~","","","","","","","",""
39,"1","R29","200","Device:R_Small","Resistor_SMD:R_0402_1005Metric","~","","","","","","","",""
40,"2","R31, R32","na","Device:R_Small","Resistor_SMD:R_0402_1005Metric","~","","","","","","","",""
41,"2","RV1, RV2","20k","Device:R_Potentiometer_Small","BSPD_07:POT-3296X1223LF","~","","","","","","","",""
42,"1","TP1","TPS","Connector:TestPoint_Small","TestPoint:TestPoint_Pad_D1.0mm","~","","","","","","","",""
43,"1","TP2","BRK","Connector:TestPoint_Small","TestPoint:TestPoint_Pad_D1.0mm","~","","","","","","","",""
44,"1","TP3","ERR_FINAL","Connector:TestPoint_Small","TestPoint:TestPoint_Pad_D1.0mm","~","","","","","","","",""
45,"1","TP4","CUR","Connector:TestPoint_Small","TestPoint:TestPoint_Pad_D1.0mm","~","","","","","","","",""
46,"1","U2","TLP175A / COMUS AB38-Q","Relay_SolidState:TLP175A","Package_SO:MFSOP6-4_4.4x3.6mm_P1.27mm","https://toshiba.semicon-storage.com/info/docget.jsp?did=13665&prodName=TLP175A","","","","","","","",""
