PGRacing/BSPD-07/PCB/BSPD-07/Additional/3296X-1-203LF-POT/3296X-1-203LF.stp

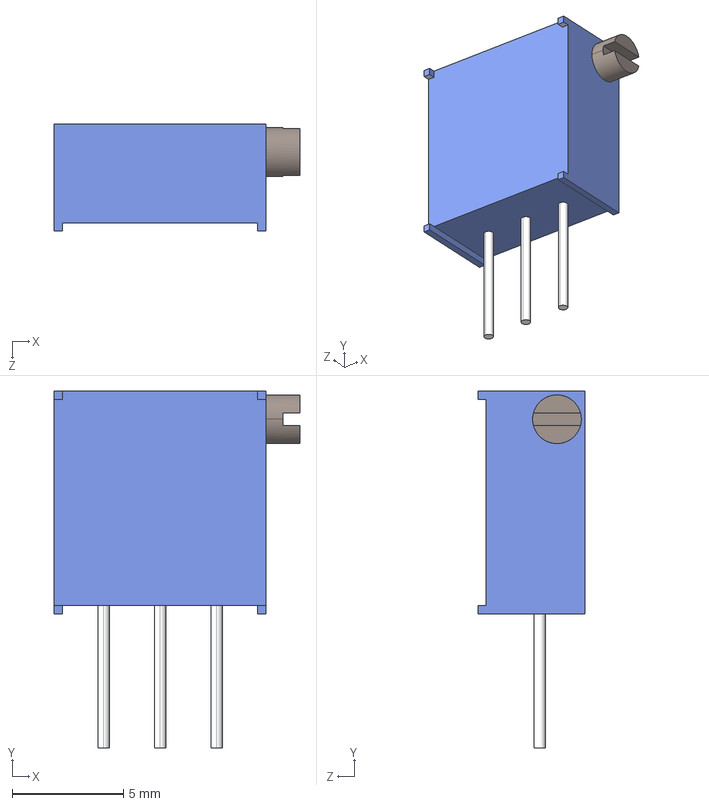
[picture p1: CAD file, 2023-02-20]
PCB/BSPD-07/Additional/3296X-1-203LF-POT/3296X-1-203LF.stp
11.0 x 16.1 x 4.83 mm
