PGRacing/BSPD-07/PCB/BSPD-07/Additional/3D_MODEL/APHBM2012SURKCGKC.stp

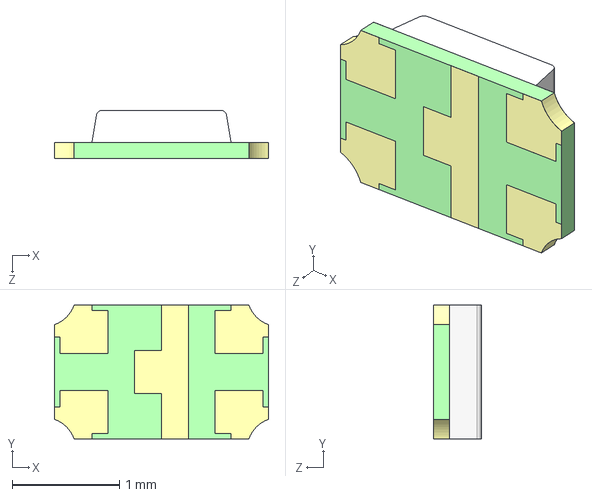
[picture p2: CAD file, 2023-02-20]
PCB/BSPD-07/Additional/3D_MODEL/APHBM2012SURKCGKC.stp
2.00 x 1.25 x 0.45 mm
