PGRacing/BSPD-07/PCB/BSPD-07/Additional/RJU002N06FRAT106/RJU002N06FRAT106.stp

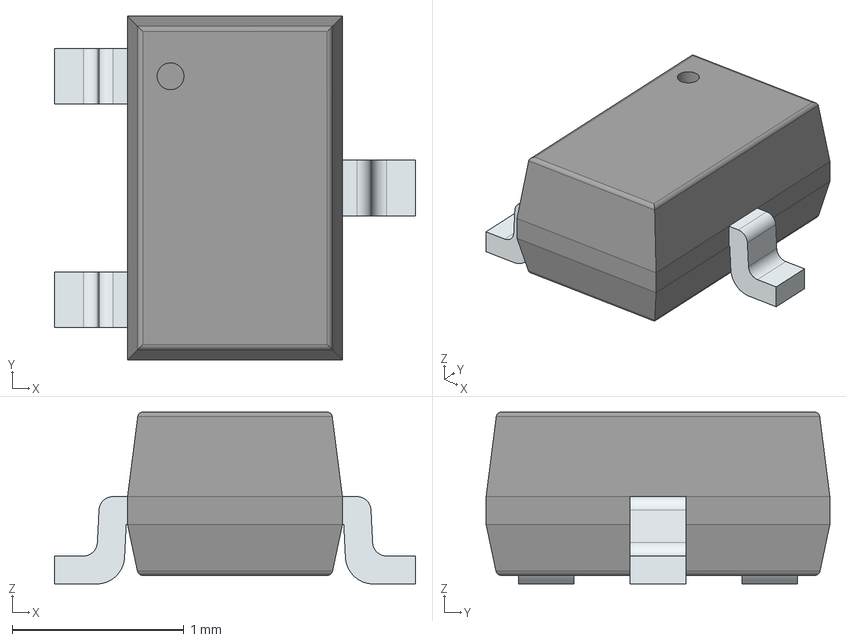
[picture p3: CAD file, 2023-02-20]
PCB/BSPD-07/Additional/RJU002N06FRAT106/RJU002N06FRAT106.stp
2.10 x 2.00 x 1.00 mm
PinsArrayL
FilletPinR
