PGRacing/BSPD-07/PCB/BSPD-07/Additional/3D_MODEL/LM393LVQDRQ1.stp

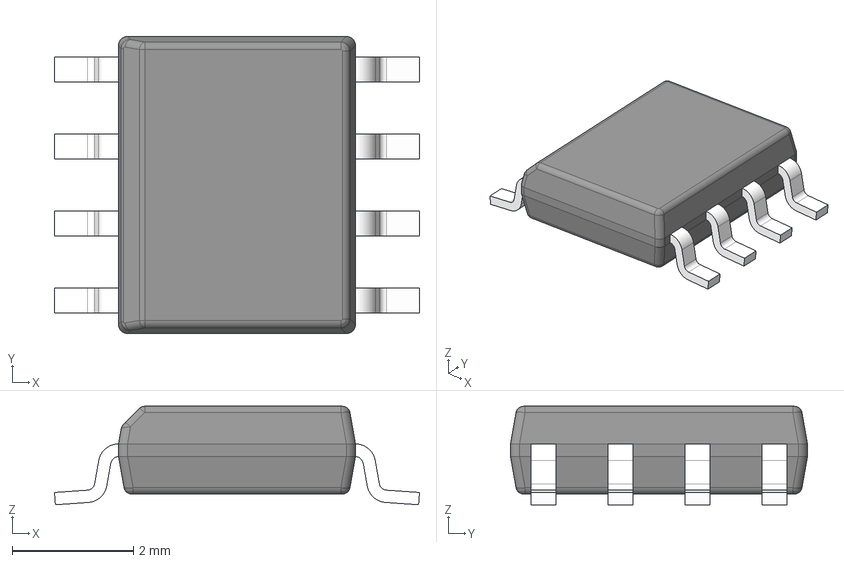
[picture p4: CAD file, 2023-02-20]
PCB/BSPD-07/Additional/3D_MODEL/LM393LVQDRQ1.stp
6.02 x 4.90 x 1.63 mm
BODY-SO
LEAD-D0008A x 8
