PGRacing/BSPD-07/PCB/BSPD-07/Additional/3D_MODEL/74LVC1G02GW-Q100H.stp

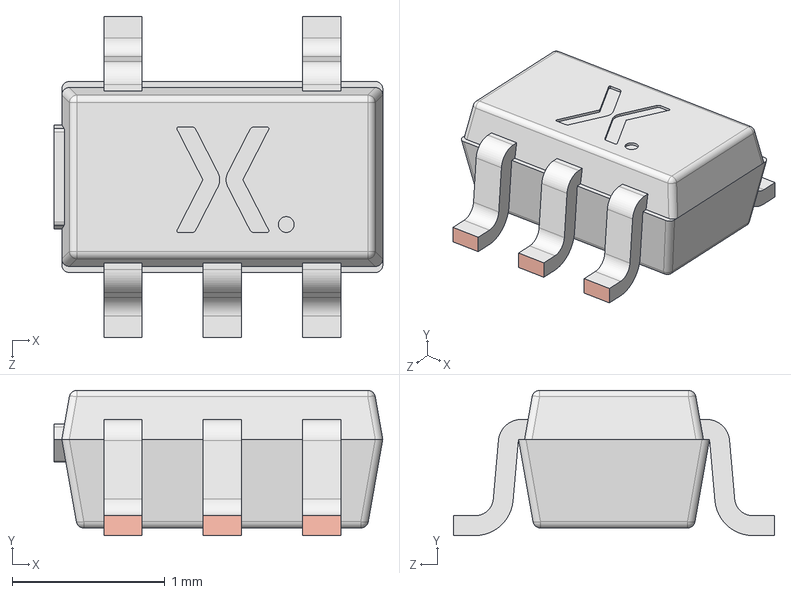
[picture p5: CAD file, 2023-02-20]
PCB/BSPD-07/Additional/3D_MODEL/74LVC1G02GW-Q100H.stp
2.15 x 0.95 x 2.10 mm
SOT353-1 Lower body
SOT353-1 Lead x 5
SOT353-1 Upper body
