PGRacing/BSPD-07/PCB/BSPD-07/Additional/3D_MODEL/LDO40LPU50RY.stp

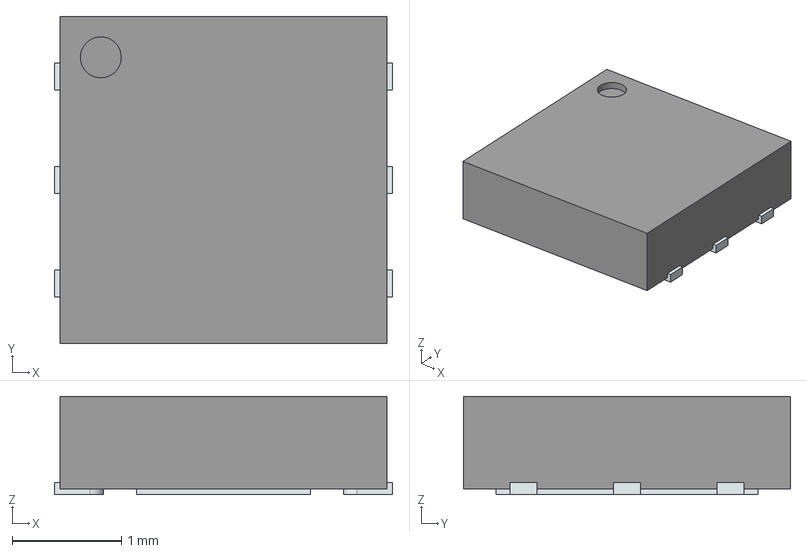
[picture p6: CAD file, 2023-02-20]
PCB/BSPD-07/Additional/3D_MODEL/LDO40LPU50RY.stp
3.10 x 3.00 x 0.9 mm
ThermalPin
PinsArrayLR
