PGRacing/BSPD-07/PCB/BSPD-07/Additional/3D_MODEL/DTM13-12PA.stp

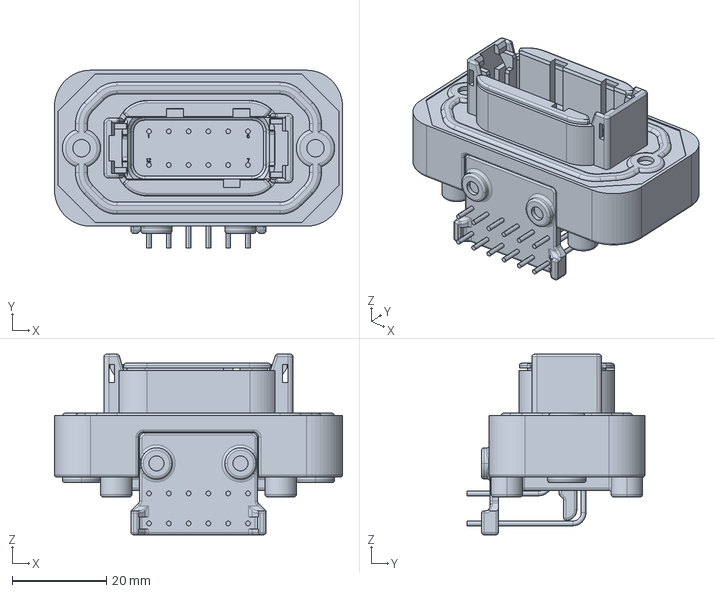
[picture p7: CAD file, 2023-02-18]
PCB/BSPD-07/Additional/3D_MODEL/DTM13-12PA.stp
61.0 x 37.6 x 38.2 mm
