PGRacing/BSPD-07/DOCS/BSPD_FSG.pdf

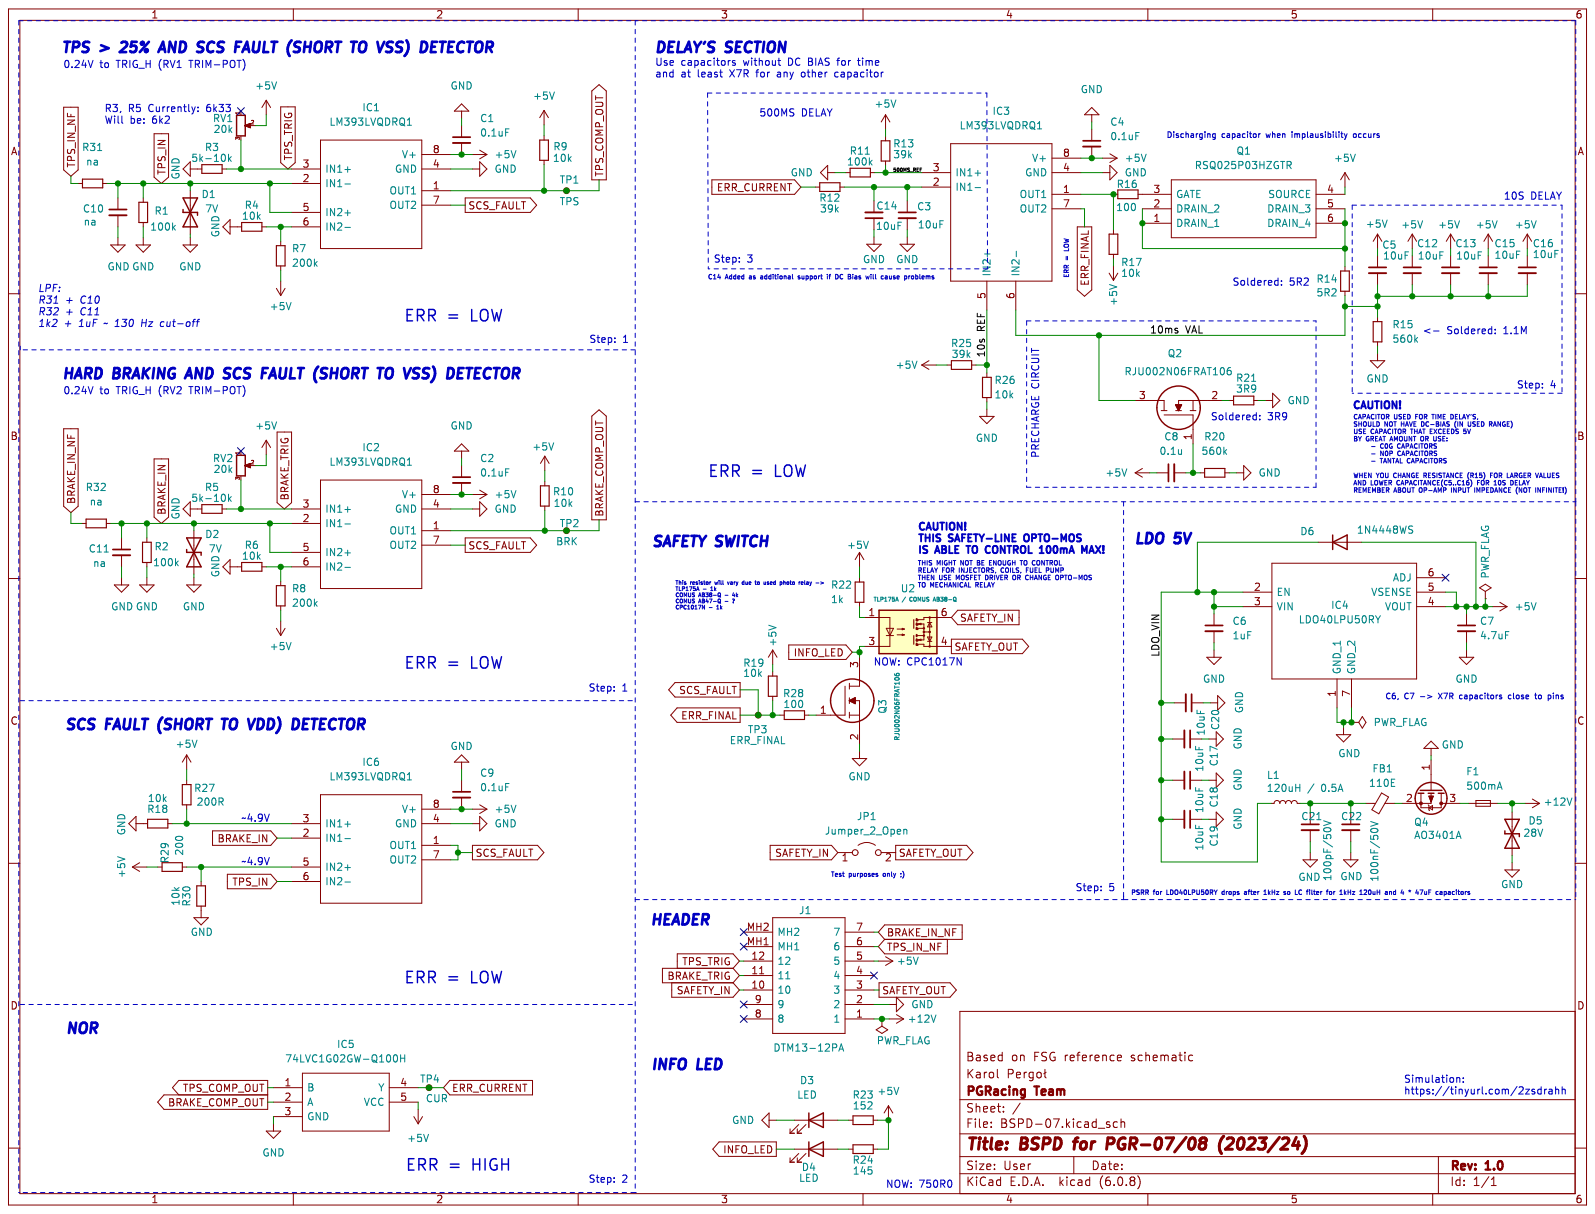
[picture p8: page 1]
