PGRacing/BSPD-07/PCB/BSPD-07/BSPD-07.kicad_pcb

## KiCad design PCB/BSPD-07/BSPD-07.kicad_pcb (2025-04-18)

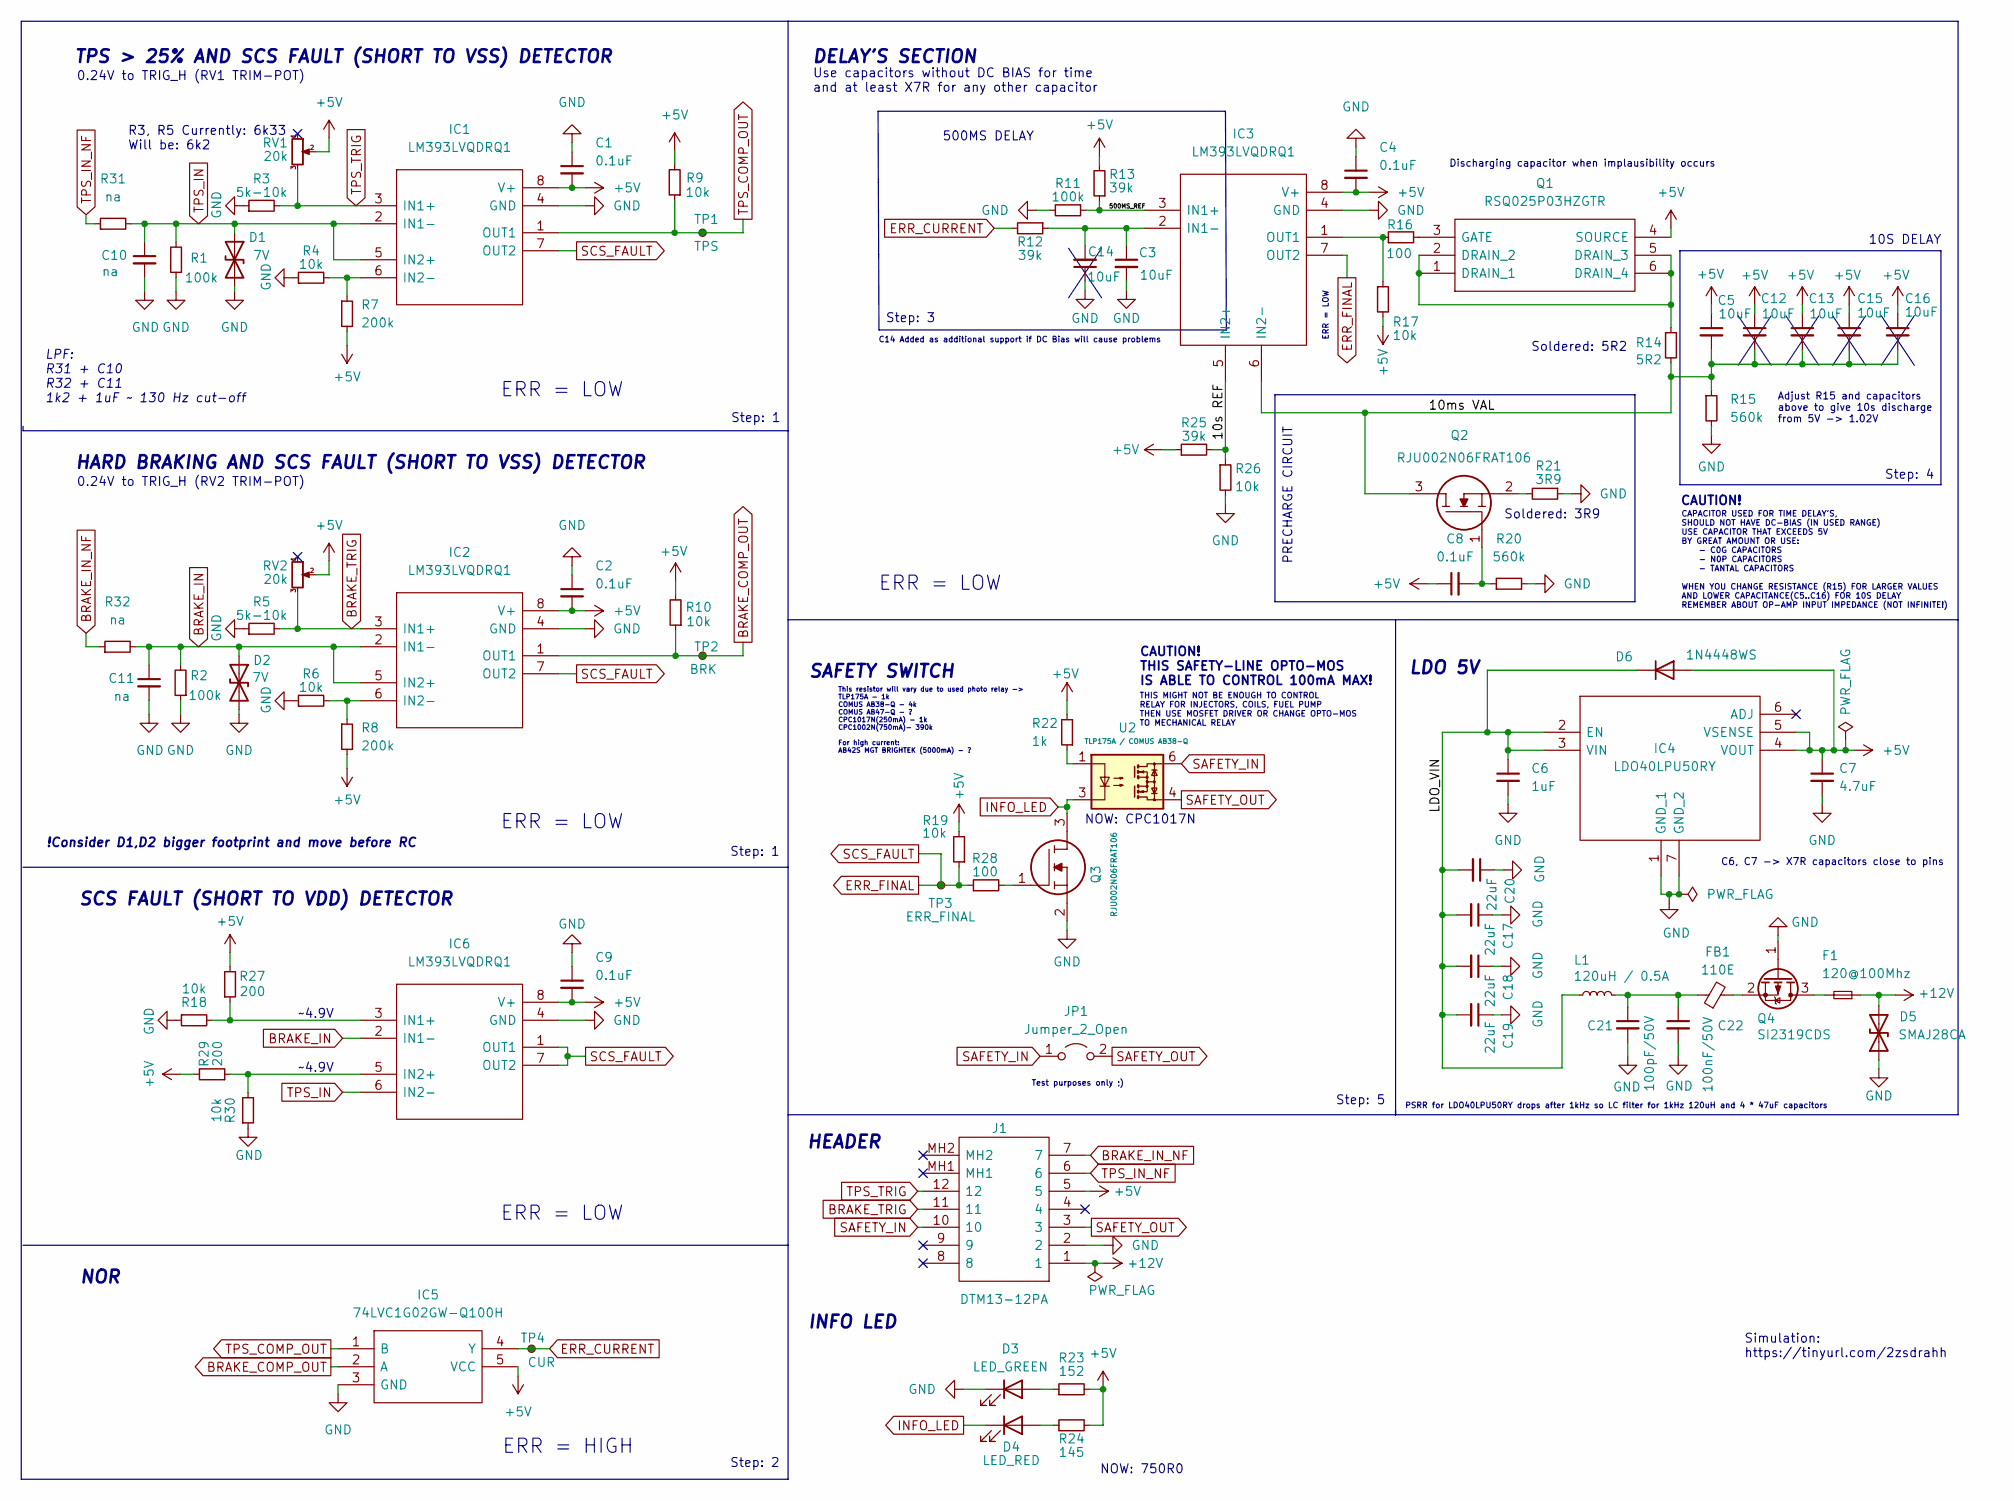
[picture p9: schematic BSPD-07.kicad_sch, BSPD for PGR-07/08 (2023/24)]

Parts:
C1, C2, C4, C8, C9: 0.1uF; C_0402_1005Metric
C3: 10uF; C_0805_2012Metric
C5, C12, C13, C14, C15, C16: 10uF; C_1206_3216Metric
C6: 1uF; C_0805_2012Metric
C7: 4.7uF; C_0805_2012Metric
C10, C11: na; C_0402_1005Metric
C17, C18, C19, C20: 22uF; C_1206_3216Metric
C21: 100pF/50V; C_0402_1005Metric
C22: 100nF/50V; C_0402_1005Metric
D1, D2: 7V; D_0402_1005Metric
D3: LED_GREEN; D_0402_1005Metric_Pad0.77x0.64mm_HandSolder
D4: LED_RED; D_0402_1005Metric_Pad0.77x0.64mm_HandSolder
D5: SMAJ28CA; D_SMA
D6: 1N4448WS; D_SOD-323
F1: 120@100Mhz; Fuse_0805_2012Metric
FB1: 110E; LED_0805_2012Metric
IC1, IC2, IC3, IC6: LM393LVQDRQ1; SOIC127P600X175-8N; Manufacturer_Part_Number LM393LVQDRQ1; Mouser Part Number 595-LM393LVQDRQ1
IC4: LDO40LPU50RY; SON95P300X300X90-7N-D; Manufacturer_Part_Number LDO40LPU50RY; Mouser Part Number 511-LDO40LPU50RY
IC5: 74LVC1G02GW-Q100H; SOT65P212X110-5N; Manufacturer_Part_Number 74LVC1G02GW-Q100H; Mouser Part Number 771-74LVC1G02GWQ100H
J1: DTM13-12PA; DTM1312PA; Manufacturer_Part_Number DTM13-12PA; Mouser Part Number 571-DTM13-12PA
JP1: Jumper_2_Open; PinHeader_1x02_P2.54mm_Vertical
L1: 120uH / 0.5A; L_1812_4532Metric
Q1: RSQ025P03HZGTR; SOT95P280X100-6N; Manufacturer_Part_Number RSQ025P03HZGTR; Mouser Part Number 755-RSQ025P03HZGTR
Q2, Q3: RJU002N06FRAT106; SOT65P210X100-3N; Manufacturer_Part_Number RJU002N06FRAT106; Mouser Part Number 755-RJU002N06FRAT106
Q4: SI2319CDS; SOT-23
R1, R2, R11: 100k; R_0402_1005Metric
R3, R5: 5k-10k; R_0402_1005Metric
R4, R6, R9, R10, R17, R18, R19, R26, R30: 10k; R_0402_1005Metric
R7, R8: 200k; R_0402_1005Metric
R12, R13, R25: 39k; R_0402_1005Metric
R14: 5R2; R_0402_1005Metric
R15, R20: 560k; R_0402_1005Metric
R16, R28: 100; R_0402_1005Metric
R21: 3R9; R_0402_1005Metric
R22: 1k; R_0402_1005Metric
R23: 152; R_0402_1005Metric
R24: 145; R_0402_1005Metric
R27, R29: 200; R_0402_1005Metric
R31, R32: na; R_0402_1005Metric
RV1, RV2: 20k; POT-3296X1223LF
TP1: TPS; TestPoint_Pad_D1.0mm
TP2: BRK; TestPoint_Pad_D1.0mm
TP3: ERR_FINAL; TestPoint_Pad_D1.0mm
TP4: CUR; TestPoint_Pad_D1.0mm
U2: TLP175A / COMUS AB38-Q; MFSOP6-4_4.4x3.6mm_P1.27mm

Connections:
+5V: C1.2, C2.2, C4.2, C5.1, C7.1, C8.1, C9.2, C12.1, C13.1, C15.1, C16.1, D6.2 (A), IC1.8 (V+), IC2.8 (V+), IC3.8 (V+), IC4.4 (VOUT), IC4.5 (VSENSE), IC5.5 (VCC), IC6.8 (V+), J1.5, Q1.4 (SOURCE), R7.2, R8.2, R9.2, R10.2, R13.2, R17.2, R19.2, R22.2, R23.2, R24.2, R25.1, R27.2, R29.2, RV1.2, RV2.2
+12V: D5.2 (A2), F1.1, J1.1
/10ms VAL: C5.2, C12.2, C13.2, C15.2, C16.2, IC3.6 (IN2-), Q2.3, R14.2, R15.1
/10s REF: IC3.5 (IN2+), R25.2, R26.1
/500MS_REF: IC3.3 (IN1+), R11.1, R13.1
/LDO_VIN: C6.1, C17.2, C18.2, C19.2, C20.2, D6.1 (K), IC4.2 (EN), IC4.3 (VIN), L1.1
BRAKE_COMP_OUT: IC2.1 (OUT1), IC5.2 (A), R10.1, TP2.1
BRAKE_IN: C11.1, D2.1 (A1), IC2.2 (IN1-), IC2.5 (IN2+), IC6.2 (IN1-), R2.2, R32.2
BRAKE_IN_NF: J1.7, R32.1
BRAKE_TRIG: IC2.3 (IN1+), J1.11, R5.2, RV2.3
ERR_CURRENT: IC5.4 (Y), R12.2, TP4.1
ERR_FINAL: IC1.7 (OUT2), IC2.7 (OUT2), IC3.7 (OUT2), IC6.1 (OUT1), IC6.7 (OUT2), R19.1, R28.1, TP3.1
GND: C1.1, C2.1, C3.2, C4.1, C6.2, C7.2, C9.1, C10.2, C11.2, C14.1, C17.1, C18.1, C19.1, C20.1, C21.2, C22.2, D1.2 (A2), D2.2 (A2), D3.1 (K), D5.1 (A1), IC1.4 (GND), IC2.4 (GND), IC3.4 (GND), IC4.1 (GND_1), IC4.7 (GND_2), IC5.3 (GND), IC6.4 (GND), J1.2, Q3.2, Q4.1 (G), R1.1, R2.1, R3.1, R4.1, R5.1, R6.1, R11.2, R15.2, R18.1, R20.2, R21.1, R26.2, R30.1
INFO_LED: D4.1 (K), Q3.3, U2.3
unnamed: C8.2, Q2.1, R20.1
unnamed: C3.1, C14.2, IC3.2 (IN1-), R12.1
unnamed: C21.1, C22.1, FB1.1, L1.2
unnamed: D3.2 (A), R23.1
unnamed: D4.2 (A), R24.1
unnamed: F1.2, Q4.3 (D)
unnamed: FB1.2, Q4.2 (S)
unnamed: IC1.6 (IN2-), R4.2, R7.1
unnamed: IC2.6 (IN2-), R6.2, R8.1
unnamed: IC3.1 (OUT1), R16.1, R17.1
unnamed: IC6.3 (IN1+), R18.2, R27.1
unnamed: IC6.5 (IN2+), R29.1, R30.2
unnamed: Q1.1 (DRAIN_1), Q1.2 (DRAIN_2), Q1.5 (DRAIN_3), Q1.6 (DRAIN_4), R14.1
unnamed: Q1.3 (GATE), R16.2
unnamed: Q2.2, R21.2
unnamed: Q3.1, R28.2
unnamed: R22.1, U2.1
SAFETY_IN: J1.10, JP1.1 (A), U2.6
SAFETY_OUT: J1.3, JP1.2 (B), U2.4
TPS_COMP_OUT: IC1.1 (OUT1), IC5.1 (B), R9.1, TP1.1
TPS_IN: C10.1, D1.1 (A1), IC1.2 (IN1-), IC1.5 (IN2+), IC6.6 (IN2-), R1.2, R31.2
TPS_IN_NF: J1.6, R31.1
TPS_TRIG: IC1.3 (IN1+), J1.12, R3.2, RV1.3

Notes on the sheet:
PRECHARGE CIRCUIT
R3, R5 Currently: 6k33 Will be: 6k2
~4.9V
ERR = LOW
PSRR for LDO40LPU50RY drops after 1kHz so LC filter for 1kHz 120uH and 4 * 47uF capacitors
0.24V to TRIG_H (RV1 TRIM-POT)
Soldered: 5R2
Step: 5
Discharging capacitor when implausibility occurs
This resistor will vary due to used photo relay -> TLP175A - 1k COMUS AB38-Q - 4k COMUS AB47-Q - ? CPC1017N(250mA) - 1k CPC1002N(750mA)- 390k For high current: AB42S MGT BRIGHTEK (5000mA) - ?
NOW: CPC1017N
LPF: R31 + C10 R32 + C11 1k2 + 1uF ~ 130 Hz cut-off
Test purposes only ;)
10S DELAY
HEADER
INFO LED
CAPACITOR USED FOR TIME DELAY'S, SHOULD NOT HAVE DC-BIAS (IN USED RANGE) USE CAPACITOR THAT EXCEEDS 5V BY GREAT AMOUNT OR USE: - C0G CAPACITORS - N0P CAPACITORS - TANTAL CAPACITORS WHEN YOU CHANGE RESISTANCE (R15) FOR LARGER VALUES AND LOWER CAPACITANCE(C5..C16) FOR 10S DELAY REMEMBER ABOUT OP-AMP 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
DELAY'S SECTION
500MS DELAY
Step: 2
Step: 4
Step: 1
NOR
Simulation: https://tinyurl.com/2zsdrahh
C6, C7 -> X7R capacitors close to pins
TPS > 25% AND SCS FAULT (SHORT TO VSS) DETECTOR
THIS MIGHT NOT BE ENOUGH TO CONTROL RELAY FOR INJECTORS, COILS, FUEL PUMP THEN USE MOSFET DRIVER OR CHANGE OPTO-MOS TO MECHANICAL RELAY
SAFETY SWITCH
CAUTION!
Step: 3
NOW: 750R0
LDO 5V
!Consider D1,D2 bigger footprint and move before RC
CAUTION! THIS SAFETY-LINE OPTO-MOS IS ABLE TO CONTROL 100mA MAX!
ERR = HIGH
HARD BRAKING AND SCS FAULT (SHORT TO VSS) DETECTOR
Use capacitors without DC BIAS for time and at least X7R for any other capacitor
SCS FAULT (SHORT TO VDD) DETECTOR
C14 Added as additional support if DC Bias will cause problems
0.24V to TRIG_H (RV2 TRIM-POT)
Adjust R15 and capacitors above to give 10s discharge from 5V -> 1.02V
Soldered: 3R9

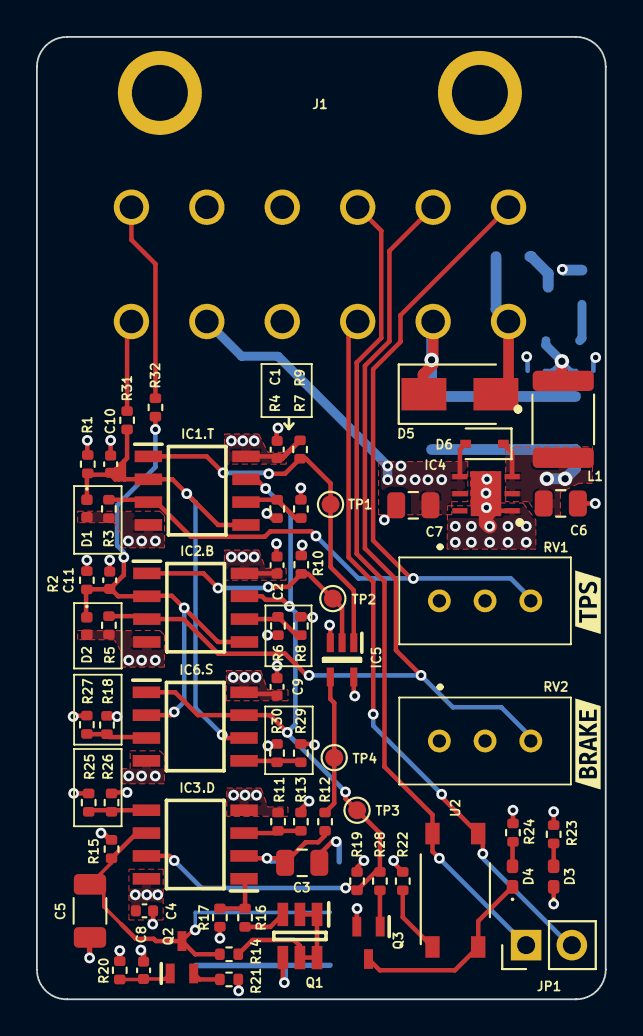
[picture p10: board BSPD-07.kicad_pcb from above]

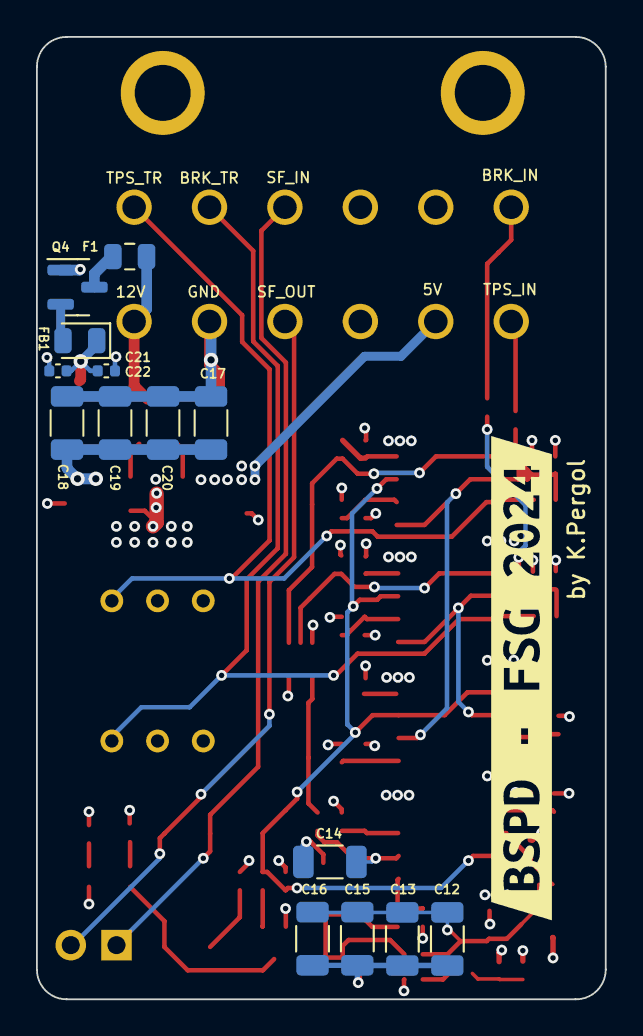
[picture p11: board BSPD-07.kicad_pcb from below]

Board: 4 copper layers, 31.6 x 53.5 mm, 85 parts (15 on the bottom side), 37 nets.

Other parts of the board:
kibuzzard-664CB14A: G***; kibuzzard-664CB14A
kibuzzard-664CB150: G***; kibuzzard-664CB150
kibuzzard-6551674A: G***; kibuzzard-6551674A
