PGRacing/BSPD-07/(commit log)

2023-02-18 Initial commit with PCB desing
    [BSPD-07.kicad_pcb, BSPD-07.kicad_sch]
2023-02-18 Added connector and delay section
    [BSPD-07.kicad_pcb, BSPD-07.kicad_sch, DTM13-12PA.stp]
2023-02-18 New revision with LDO40L
    [BSPD-07.kicad_pcb, BSPD-07.kicad_sch]
2023-02-19 Almost finished schematics
    [BSPD-07.kicad_pcb, BSPD-07.kicad_sch]
2023-02-20 Added precharge circuit example sim
2023-02-20 Finished schematics
    [3296X-1-203LF.stp, 74LVC1G02GW-Q100H.stp, BSPD-07.kicad_pcb, BSPD-07.kicad_sch, DTM13-12PA.stp, LDO40LPU50RY.stp, LM393LVQDRQ1.stp, RJU002N06FRAT106.stp]
2023-02-20 Added info led
    [APHBM2012SURKCGKC.stp, BSPD-07.kicad_pcb, BSPD-07.kicad_sch]
2023-02-20 Fixed delay resistor reference value
    [BSPD-07.kicad_pcb, BSPD-07.kicad_sch]
2023-02-21 Initial board layout with two comparators
    [BSPD-07.kicad_pcb, BSPD-07.kicad_sch]
2023-02-21 500ms section layout
    [BSPD-07.kicad_pcb, BSPD-07.kicad_sch]
2023-02-21 Finished PCB layout
    [BSPD-07.kicad_pcb, BSPD-07.kicad_sch]
2023-02-21 Rounded corners
    [BSPD-07.kicad_pcb]
2023-02-21 Tinkle of a rose petal ;)
    [BSPD-07.kicad_pcb, BSPD-07.kicad_sch]
2023-03-20 Generated gerbers
    [BSPD-07-B_Cu.gbr, BSPD-07-B_Mask.gbr, BSPD-07-B_Paste.gbr, BSPD-07-B_Silkscreen.gbr, BSPD-07-Edge_Cuts.gbr, BSPD-07-F_Cu.gbr, BSPD-07-F_Mask.gbr, BSPD-07-F_Paste.gbr]
2023-05-07 Added error labels
    [BSPD-07.kicad_sch]
2023-05-30 Finished board - working prototype
    [BSPD-07.kicad_sch]
2023-05-30 Initial silkscreen rework
    [BSPD-07.kicad_pcb]
2023-05-30 Layout rework + led change
    [BSPD-07.kicad_pcb, BSPD-07.kicad_sch]
2023-05-30 Reworked layout finished
    [BSPD-07.kicad_pcb]
2023-05-30 Revised layout
    [BSPD-07.kicad_pcb, BSPD-07.kicad_sch]
2023-05-30 Revised layout changed board outline
    [BSPD-07.kicad_pcb]
2023-05-30 Revised layout B - finished
    [BSPD-07.kicad_pcb]
2023-10-04 Final version with gerbers generated
    [BSPD-07-B_Cu.gbr, BSPD-07-B_Mask.gbr, BSPD-07-B_Paste.gbr, BSPD-07-B_Silkscreen.gbr, BSPD-07-Edge_Cuts.gbr, BSPD-07-F_Cu.gbr, BSPD-07-F_Mask.gbr, BSPD-07-F_Paste.gbr]
2023-10-04 Added SCS compliant solution ver 1.0
    [BSPD-07.kicad_pcb, BSPD-07.kicad_sch]
2023-10-04 WIP layouting SCS section
    [BSPD-07.kicad_pcb, BSPD-07.kicad_sch]
2023-11-13 New layout for 2024 - scs compliance
    [BSPD-07-B_Cu.gbr, BSPD-07-B_Mask.gbr, BSPD-07-B_Paste.gbr, BSPD-07-B_Silkscreen.gbr, BSPD-07-Edge_Cuts.gbr, BSPD-07-F_Cu.gbr, BSPD-07-F_Mask.gbr, BSPD-07-F_Paste.gbr]
2024-02-28 Added adnotations during soldering
    [BSPD-07.csv, BSPD-07.kicad_sch]
2024-03-02 Minor changes after assembly
    [BSPD-07.kicad_sch]
2024-05-22 Added load-dump protection (TVS), voltage input filtering and place for C0G capacitors
    [BSPD-07.csv, BSPD-07.kicad_pcb, BSPD-07.kicad_sch, ___BSPD-07.csv]
2025-04-18 Added BOM and minor changes in schematic, before elements order
    [BOM-BSPD-07.csv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]
2025-05-29 Added schematic with markup in pdf format
